ponix-dev/flow_controller/hardware/flow_controller.kicad_sch

## KiCad design hardware/flow_controller.kicad_sch (2026-05-03, last stored version)

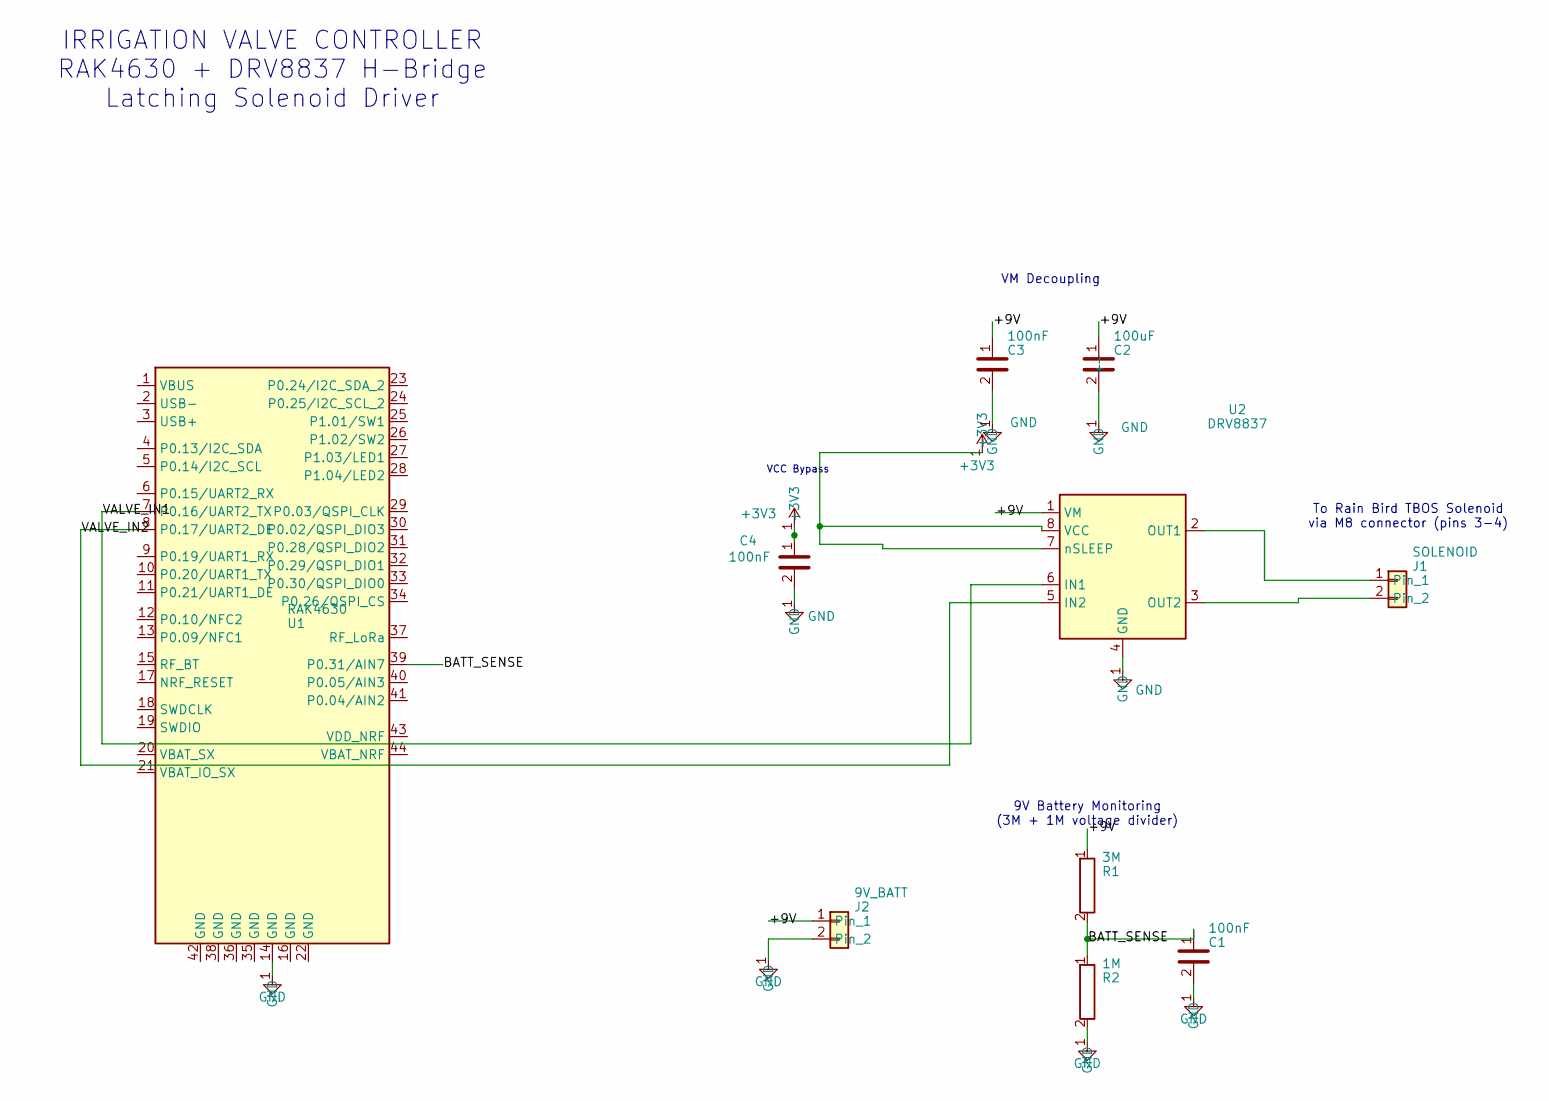
[picture p1: schematic flow_controller.kicad_sch]

Parts:
C1, C3, C4: 100nF
C2: 100uF
J1: SOLENOID
J2: 9V_BATT
R1: 3M
R2: 1M
U1: RAK4630
U2: DRV8837

Connections:
+3V3: C4.1, U2.7 (nSLEEP), U2.8 (VCC)
+9V: C2.1 (+), C3.1, J2.1, R1.1, U2.1 (VM)
BATT_SENSE: C1.1, R1.2, R2.1, U1.39 (P0.31/AIN7)
GND: C1.2, C2.2 (-), C3.2, C4.2, J2.2, R2.2, U1.14 (GND), U2.4 (GND)
unnamed: J1.1, U2.2 (OUT1)
unnamed: J1.2, U2.3 (OUT2)
VALVE_IN1: U1.7 (P0.16/UART2_TX), U2.6 (IN1)
VALVE_IN2: U1.8 (P0.17/UART2_DE), U2.5 (IN2)

Notes on the sheet:
To Rain Bird TBOS Solenoid via M8 connector (pins 3-4)
VM Decoupling
IRRIGATION VALVE CONTROLLER RAK4630 + DRV8837 H-Bridge Latching Solenoid Driver
9V Battery Monitoring (3M + 1M voltage divider)
VCC Bypass
