ponix-dev/flow_controller/domain/src/proto/mod.rs

//! Generated wire types from `proto/flow_controller/v1/*.proto`.
//!
//! Regenerate via `mise run proto:gen` after editing `.proto` files.
//! The generated file `valve.rs` (sibling of this `mod.rs`) is committed;
//! do not hand-edit.

#[allow(warnings, clippy::all)]
mod generated {
    include!("valve.rs");
}

pub use generated::flow_controller_::v1_::*;
