ponix-dev/flow_controller/firmware/src/rng.rs

use rand_core::RngCore;

/// Software PRNG for LoRaWAN (hardware RNG is borrowed by SDC).
pub(crate) struct SoftwareRng(pub(crate) u64);

impl RngCore for SoftwareRng {
    fn next_u32(&mut self) -> u32 {
        self.0 = self
            .0
            .wrapping_mul(6364136223846793005)
            .wrapping_add(1442695040888963407);
        (self.0 >> 33) as u32
    }
    fn next_u64(&mut self) -> u64 {
        ((self.next_u32() as u64) << 32) | self.next_u32() as u64
    }
    fn fill_bytes(&mut self, dest: &mut [u8]) {
        rand_core::impls::fill_bytes_via_next(self, dest)
    }
    fn try_fill_bytes(&mut self, dest: &mut [u8]) -> Result<(), rand_core::Error> {
        self.fill_bytes(dest);
        Ok(())
    }
}
