ponix-dev/flow_controller/(commit log)

2026-05-03 chore: tidy provisioning flow, add roadmap and CLI README
    - firmware: rejoin LoRaWAN when new keys arrive; skip flash write when keys unchanged
    - lorawan_flash: switch to WriteType::WithResponse so callers know the firmware accepted the keys; scrub real DevEUI from the CLI doc example
    - mise: add `erase` task that runs probe-rs erase
    - docs: add ROADMAP.md (5 phases toward Class-A polling valve controller) and lorawan_flash/README.md
    [ble.rs, lorawan.rs, main.rs, shared.rs]
2026-05-03 feat(hardware): import KiCad project as flow_controller, document RAK17001 pinout
    - Move standalone rak4630-example KiCad work into hardware/, renaming the
    project files to flow_controller.* (internal refs in .kicad_pro and
    .kicad_sch updated to match). Drops the inner .git, IDE history, backups,
    build outputs, and the standalone repo's per-project meta files.
    - Add hardware/PINOUT.md as the single source of truth for GPIO assignments
    shared by firmware and schematic. Documents the RAK19007 + RAK17001
    (STSPIN250) pin map: WB_IO2 IO-rail power, WB_IO3 PWM, WB_IO4 PH,
    WB_IO5 FAULT, WB_IO6 EN. Cross-checked against the SX1262 reserved pins.
    - Top-level README.md describes the worksp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
    [flow_controller.kicad_pcb, flow_controller.kicad_sch]
2026-05-05 docs(hardware): commit to STSPIN250 across both targets, list schematic deltas
    Both the WisBlock prototype (RAK17001) and the future custom PCB will use
    STSPIN250 H-bridges with PH/EN/PWM control, so the firmware is byte-identical.
    The current schematic uses DRV8837 (IN1/IN2 control) and must be reworked.
    - hardware/PINOUT.md: add a "Targets" section that states the dual-board
    intent, and a "Custom PCB schematic — required deltas" section listing the
    six concrete schematic changes (chip swap, FAULT pull-up, REF + sense
    resistors, VS/VCC rails, functional net labels, BATT_SENSE pin disclosure).
    - ROADMAP.md: Phase 4 picks up the schematic reconciliation as an explicit
    task; firmwar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
2026-05-05 docs: mark Phase 1 complete; refresh CLAUDE.md and README.md to current state
    - ROADMAP.md: check off all four Phase 1 items, replace pre-research wording
    (RAK13002 → RAK17001, DRV8833 IN1/IN2 → STSPIN250 PH/EN/PWM/FAULT) with
    what was actually researched and documented.
    - CLAUDE.md: add the H-bridge module and load to Architecture, point at
    hardware/PINOUT.md as the GPIO authority.
    - README.md: distinguish today's behavior (BLE-provisioned beacon) from the
    end-state vision; add a Status block surfacing Phase 1 done / Phase 2 next.
    - .gitignore: ignore *.kicad_prl (KiCad per-machine state) and .history/
    (VS Code Local History) so they don't leak into commits.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
2026-05-05 feat(proto): add proto/ + buf lint + micropb codegen via proto_gen
    Establishes the wire-format pipeline shared by the firmware and the future
    backend. Generated micropb types compile into the firmware but are not yet
    called from the LoRaWAN path — that's Phase 3.
    Proto layout
    - proto/buf.yaml: v2 config, lint STANDARD, breaking FILE
    - proto/flow_controller/v1/flow_controller.proto: single ValveState enum
    (UNSPECIFIED/OPEN/CLOSED/UNKNOWN) reused by Uplink and Downlink. Backend
    doesn't send UNKNOWN as a command. Nested directory matches the package
    path so PACKAGE_DIRECTORY_MATCH lint passes; a small deviation from the
    approved plan's flat layout, picked once buf STANDARD lint surfa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
    [main.rs, proto.rs]
2026-05-05 refactor(proto): rename flow_controller.proto -> valve.proto
    The schema is entirely about valve control (ValveState enum + Uplink /
    Downlink of valve state), but it lived at proto/flow_controller/v1/flow_controller.proto
    which had "flow_controller" three times in the path before you saw the
    content. Rename matches what's in the file.
    The proto package stays `flow_controller.v1`, so the inner Rust module path
    generated by micropb is unchanged (`flow_controller_::v1_::*`); the
    re-exports under `proto::*` (Uplink, Downlink, ValveState) are also
    unchanged. No callers affected — Phase 3 hasn't wired these in yet.
    Verified: proto:lint, proto:check (regen reproducible), cargo check on the
    firmw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
2026-05-05 refactor(proto): consolidate firmware/src/proto.rs into firmware/src/proto/mod.rs
    Disk layout is tidier — everything proto-related in the firmware crate
    lives in one folder instead of having both `src/proto.rs` and `src/proto/`
    side by side. `mod proto;` in main.rs is unchanged. Update the include!
    path inside mod.rs from "proto/valve.rs" to "valve.rs" since mod.rs is
    now in the same directory as the generated file.
2026-07-20 docs: add firmware workflow guides
    Add docs/ covering the core firmware workflows, grounded in the current
    firmware source, with tables and mermaid diagrams:
    - startup.md — boot sequence and BLE/LoRaWAN coordination
    - provisioning.md — flashing LoRaWAN keys over BLE
    - flash-storage.md — flash record layout and read/write
    - uplink-downlink.md — Class-A join + uplink/downlink loop
    Also ignore .thoughts/ (local planning notes).
2026-07-21 wip: domain crate + valve state machine
2026-07-27 refactor(firmware): run LoRaWAN in main, spawn BLE as background task
    LoRaWAN is the board's primary loop, so run it in the main context and spawn
    BLE provisioning as a background task instead of the reverse. The softdevice
    controller is already 'static (StaticCell-backed), so it spawns cleanly.
    Rename to match the new roles:
    ble::run_ble -> ble::provisioning_task (now a spawned task)
    lorawan::lorawan_task -> lorawan::run (now the main-context loop)
    [ble.rs, lorawan.rs, main.rs]
2026-07-27 chore(hardware): move KiCad sources to sibling flow_controller_hardware repo
    Relocate hardware/ (KiCad schematic, PCB, libraries, PINOUT.md) out of the
    firmware repo into the sibling ../flow_controller_hardware directory. Update
    firmware/docs references: board.rs repoints to the new PINOUT.md path;
    CLAUDE.md and README.md no longer reference PINOUT.md and point at the sibling
    repo; ROADMAP.md Phase 4 tasks repoint to the new path.
    [flow_controller.kicad_pcb, flow_controller.kicad_sch]
2026-07-27 feat(valve): drive closed on first boot when no state is persisted
    init_state restores a persisted Open/Closed; when no known position exists
    (no record or Unknown) it drives the valve closed and persists Closed, so a
    fresh device starts guaranteed-closed rather than assumed. Re-closing a
    latching valve is harmless.
    Adds host-tested domain::init_state and wires it into lorawan::run; documents
    the boot policy in docs/valve-states.md.
2026-07-27 refactor(proto): drop VALVE_STATE_UNKNOWN
    The device never emits UNKNOWN on the wire (boot resolves it to Closed) and
    the backend must not command it, so the value is redundant with UNSPECIFIED(0).
    Domain Unknown now maps to Unspecified; from_proto already collapses any
    non-1/2 value to Unknown, so decode is unchanged. Regenerated proto and updated
    the two wire-format tests (all-Unknown Uplink now encodes to empty).
    The domain ValveState::Unknown stays as the internal flash/erased sentinel.
    [codec.rs, runtime.rs, types.rs, valve.rs]
2026-07-27 docs: refresh for domain crate, FCV1 record, and task swap
    Bring the docs in line with the current implementation:
    - flash-storage: 40-byte FCV1 record (keys + valve state), owned by
    domain/src/record.rs.
    - uplink-downlink: real serialized Uplink/Downlink via domain::run_iteration,
    300s cadence, ValveState without UNKNOWN, downlink receipt logging.
    - startup/provisioning: LoRaWAN runs in main context, BLE provisioning_task is
    the spawned background task (was reversed).
    - proto/README: drop the removed VALVE_STATE_UNKNOWN note.
    - CLAUDE.md: correct default-members and the proto schema filename.
